evolutek/movement-tracker/V4/Output/movement-tracker V4.1.step

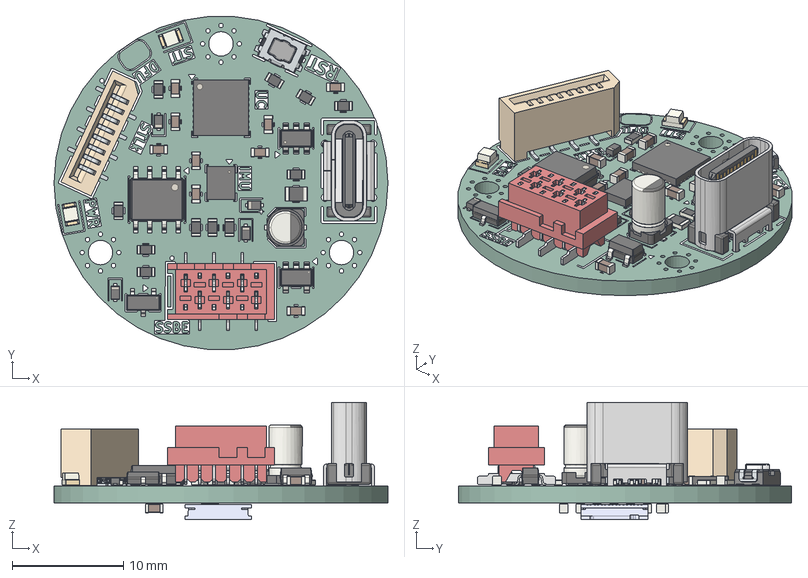
[picture p1: CAD file, 2026-03-30]
V4/Output/movement-tracker V4.1.step
30.0 x 29.9 x 10.5 mm
R_0603_1608Metric x 11
SOT-23
SOT-23-5
D_SOD-523 x 4
QFN-32-1EP_5x5mm_P0.5mm_EP3.45x3.45mm
Frame
Cover
Terminal
Button
SOT-23-6
C_0603_1608Metric x 17
LGA-14_3x2.5mm_P0.5mm_LayoutBorder3x4y
LED_0805_2012Metric x 2
Fuse_0805_2012Metric
CP_Elec_3x5.4
69036728xx76_PIN x 6
SOIC-8_3.9x4.9mm_P1.27mm
6861xx188822_Pin1 x 4
6861xx188822_Pin2 x 4
632722110112_Shielding
632722110112_Housing
632722110112_Shielding_2 x 2
632722110112_Shielding_3 x 2
632722110112_Pin_1 x 4
632722110112_Pin_2 x 16
632722110112_Pin_3 x 4
PAA5160E1-Q-16L-6x6-LGA
movement-tracker_silkscreen x 2
movement-tracker_PCB
