evolutek/movement-tracker/V1/module-optique-grand/Output/module-optique-grand.step

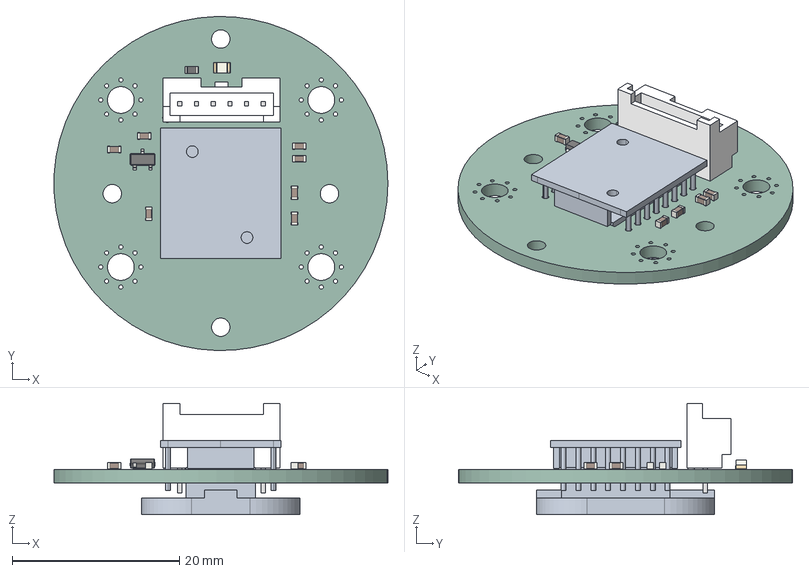
[picture p2: CAD file, 2023-09-23, an earlier design]
V1/module-optique-grand/Output/module-optique-grand.step
40.0 x 40.0 x 13.3 mm
module-optique-grand PCB
