evolutek/movement-tracker/V1/module-optique-mini/Output/module-optique.step

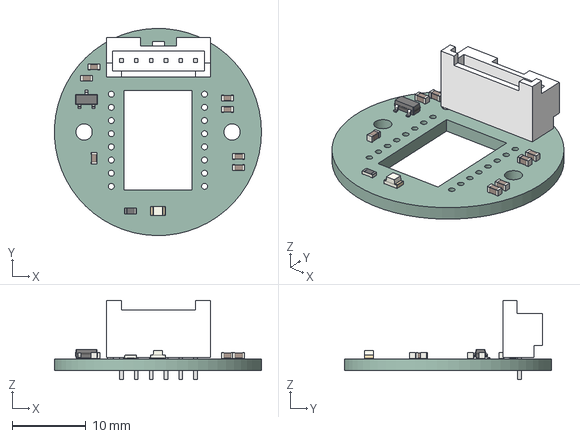
[picture p3: CAD file, 2023-09-23, an earlier design]
V1/module-optique-mini/Output/module-optique.step
28.0 x 28.0 x 10.7 mm
module-optique PCB
