evolutek/movement-tracker/V4/Output/movement-tracker.pdf

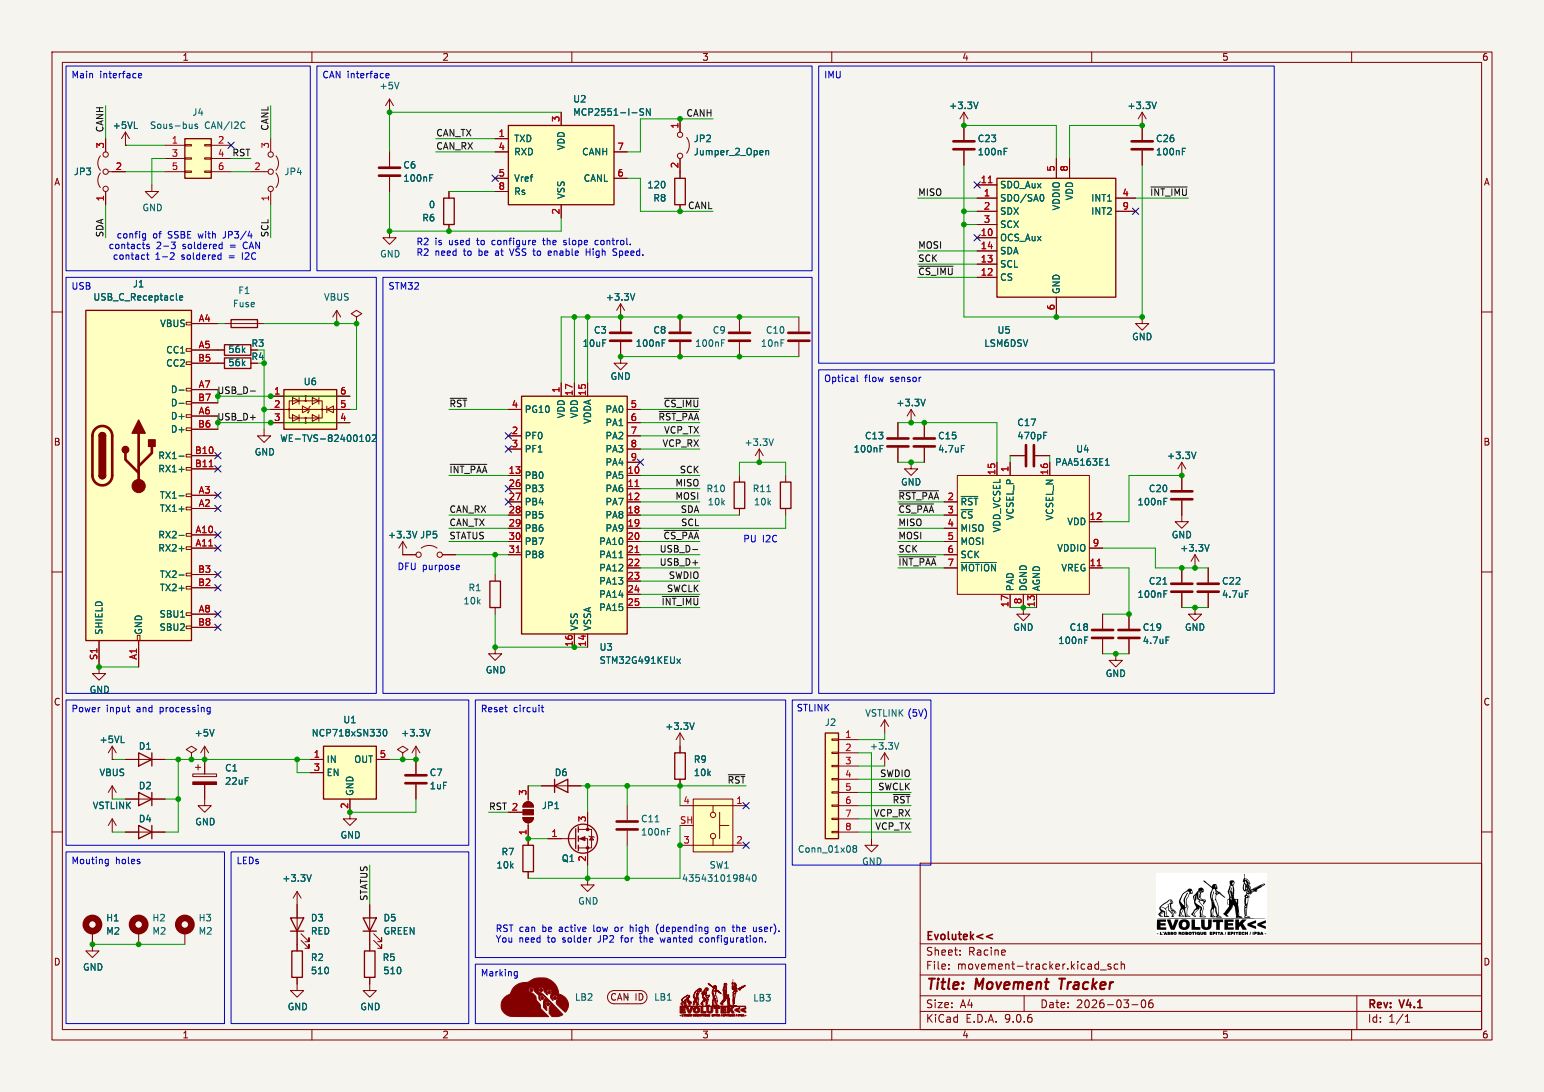
[picture p4: page 1]

Main interface USB Mouting holes

~{CS_IMU} MOSI MISO SDA CANH

4 U6 WE-TVS-82400102 GND GND

1 VDD 17 VSS 16 VDDA 15 VSSA 14 PA0 5 PA1 6 PA2 7 PA3 8 PA4 9 PA5 10 PA6 11 PA7 12 PA8 18 PA9 19 PA10 20 PA11 21 PA12 22 PA13 23 PA14 24 PA15 25 U3STM32G491KEUx R6

config of SSBE with JP3/4

1 VDD 17 VSS 16 VDDA 15 VSSA 14 PA0 5 PA1 6 PA2 7 PA3 8 PA4 9 PA5 10 PA6 11 PA7 12 PA8 18 PA9 19 PA10 20 PA11 21 PA12 22 PA13 23 PA14 24 PA15 25 +3.3V C13

~{CS_PAA} USB_D- SCL SDA MOSI VCP_RX STATUS

8 AGND 13 VCSEL_N 16 VDD 12 VDDIO 9 VREG 11 U4 PAA5163E1 +3.3V

8 AGND 13 VCSEL_N 16 VDD 12 VDDIO 9 VREG 11 +3.3V

LEDs Power input and processing

Id: 1/1 Title: Movement Tracker File: movement-tracker.kicad_sch Sheet: Racine Evolutek<<
