evolutek/movement-tracker/V3/Output/Schematics.pdf

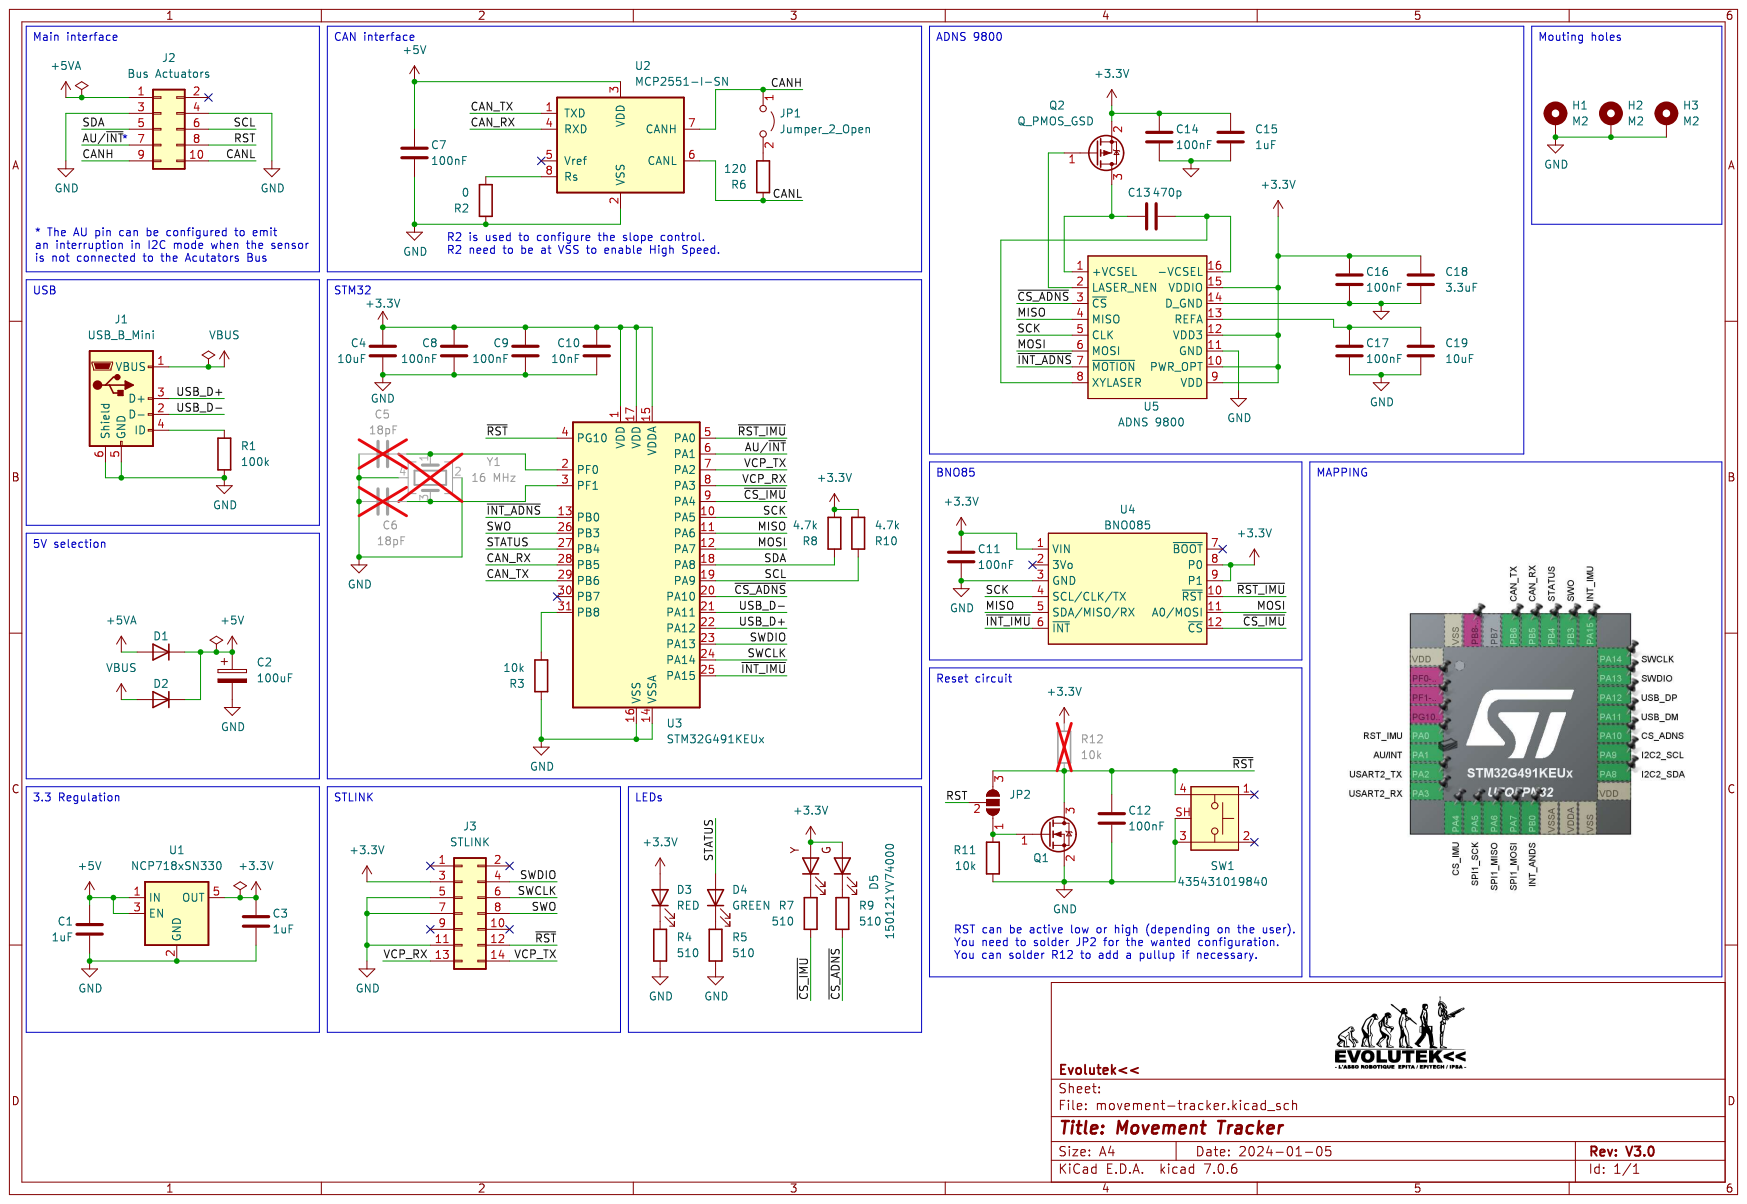
[picture p5: page 1]
