evolutek/movement-tracker/V2/Output/Schematics.pdf

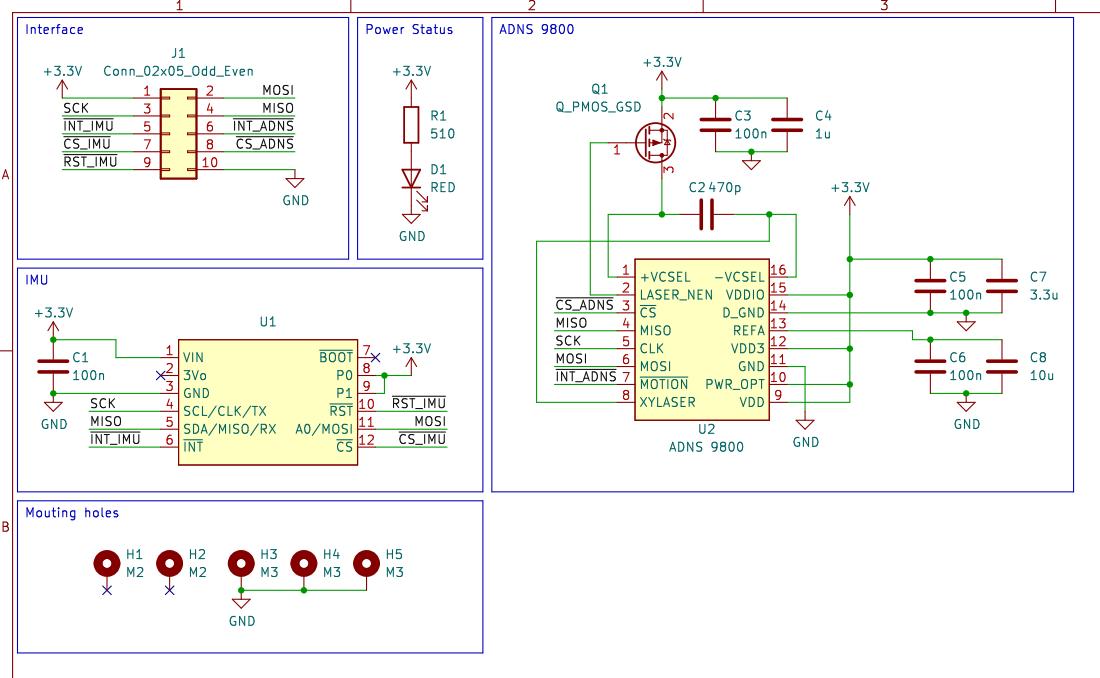
[picture p6: page 1]
