evolutek/movement-tracker/V1/module-optique-grand/Output/Schematics.pdf

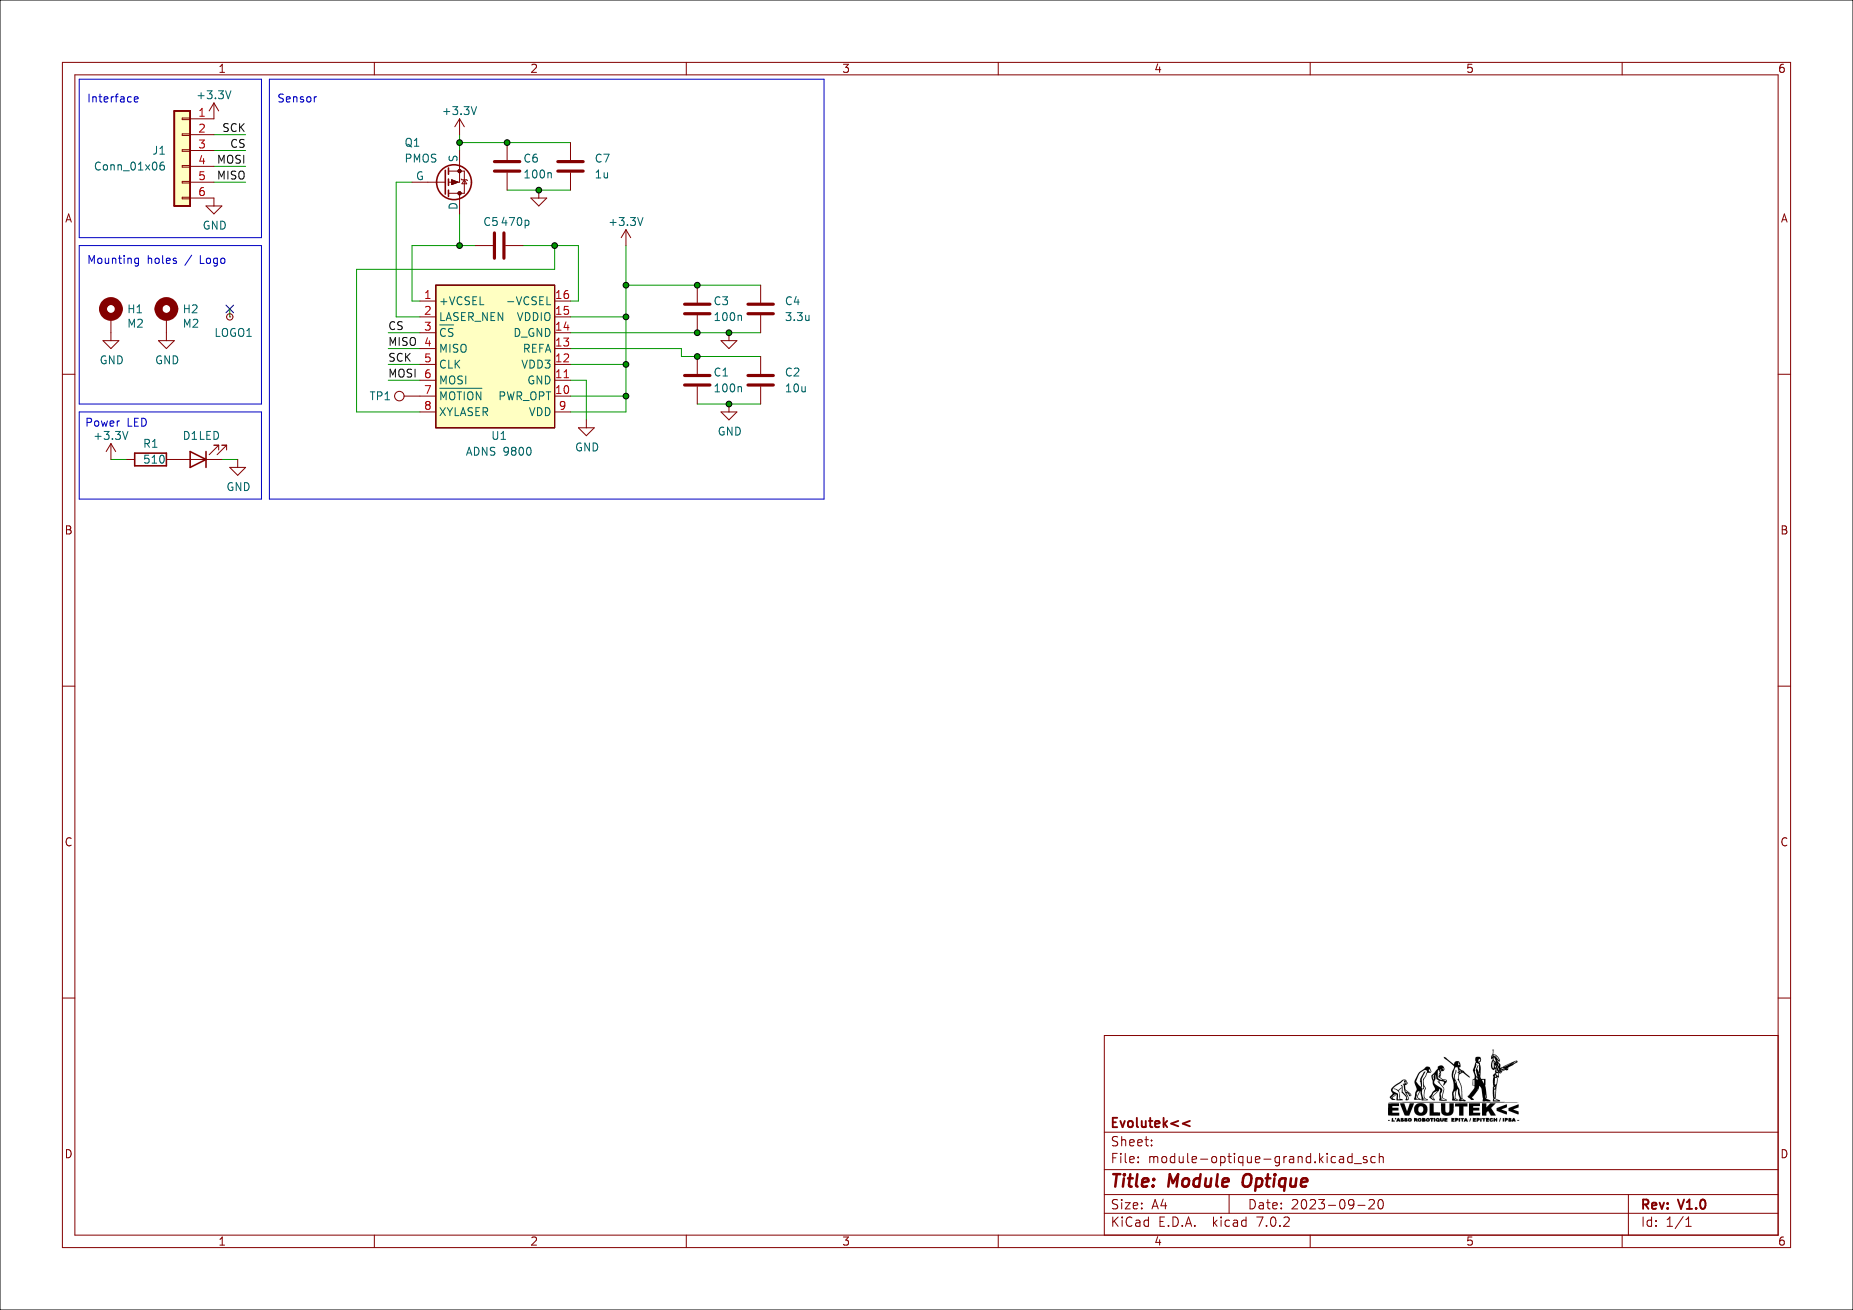
[picture p7: page 1]
