evolutek/movement-tracker/V1/module-optique-mini/Output/Schematics.pdf

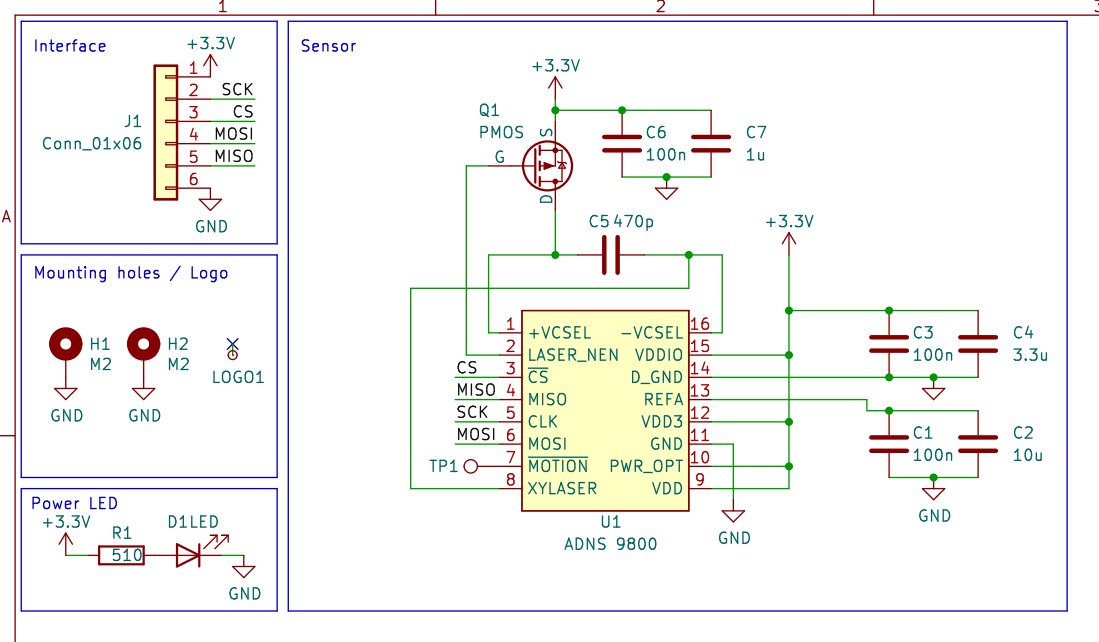
[picture p8: page 1]
