evolutek/movement-tracker/V3/Output/Board-Back.pdf

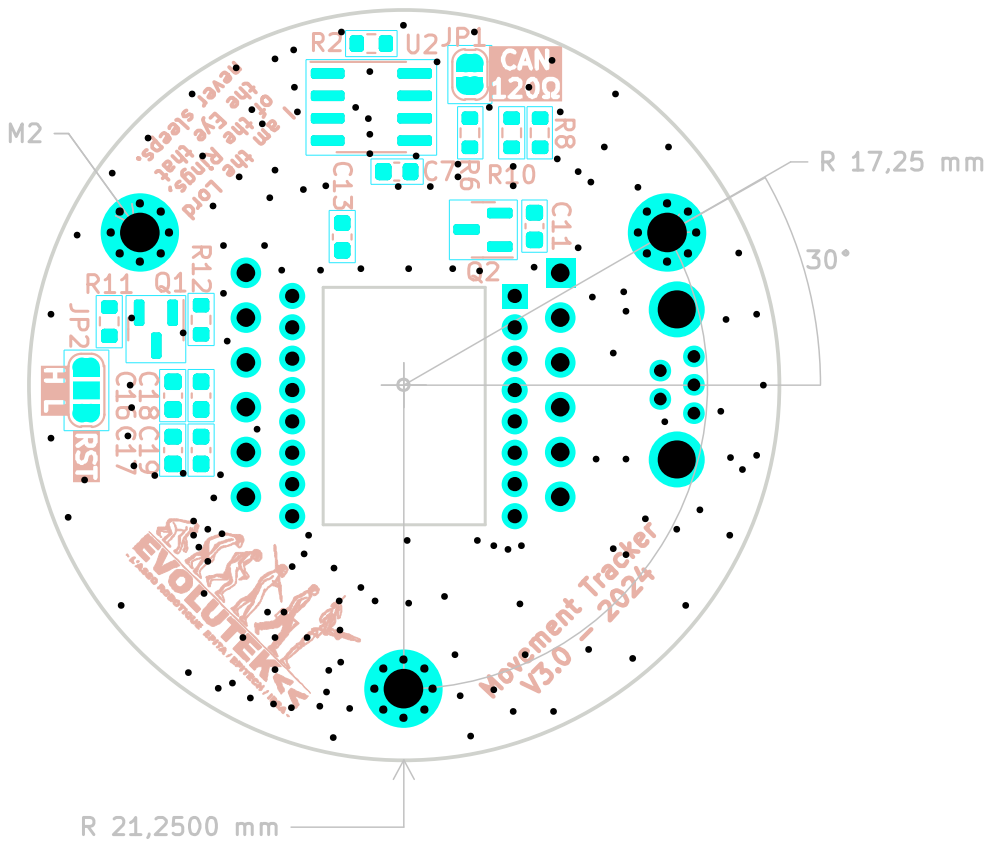
[picture p9: page 1]
