evolutek/movement-tracker/V3/Output/Board-Front.pdf

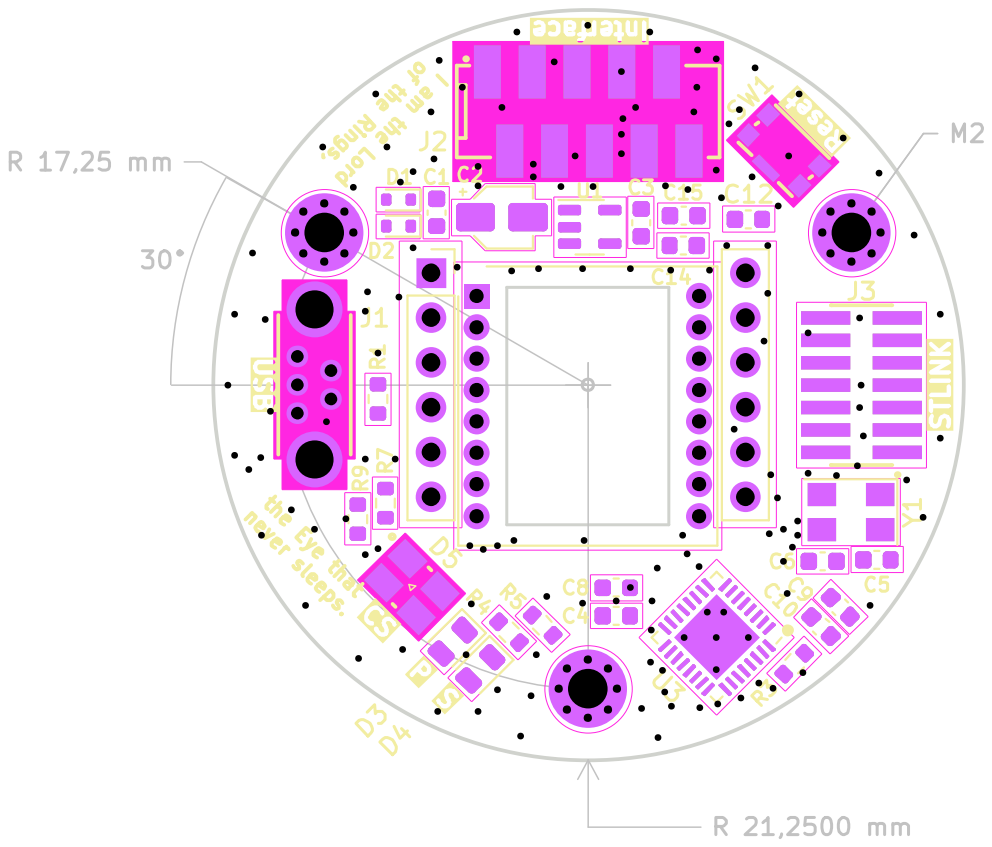
[picture p10: page 1]
