evolutek/movement-tracker/V2/Output/Board-Back.pdf

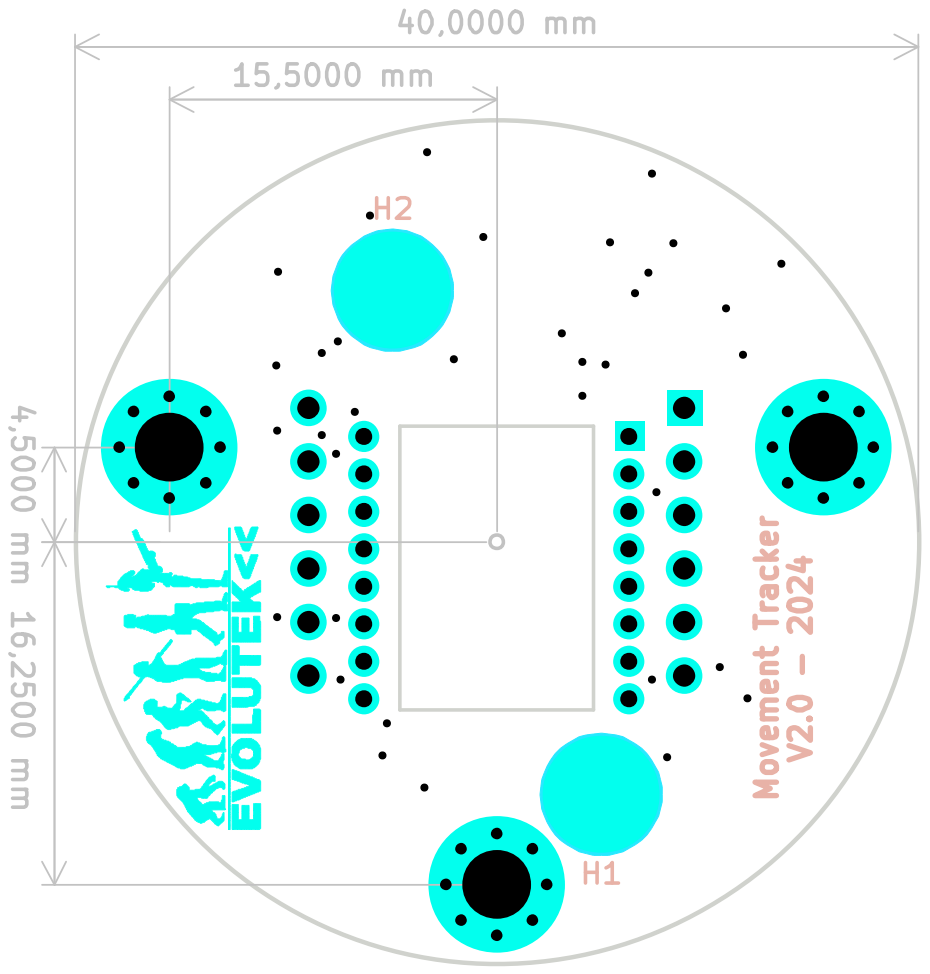
[picture p11: page 1]
