evolutek/movement-tracker/V2/Output/Board-Front.pdf

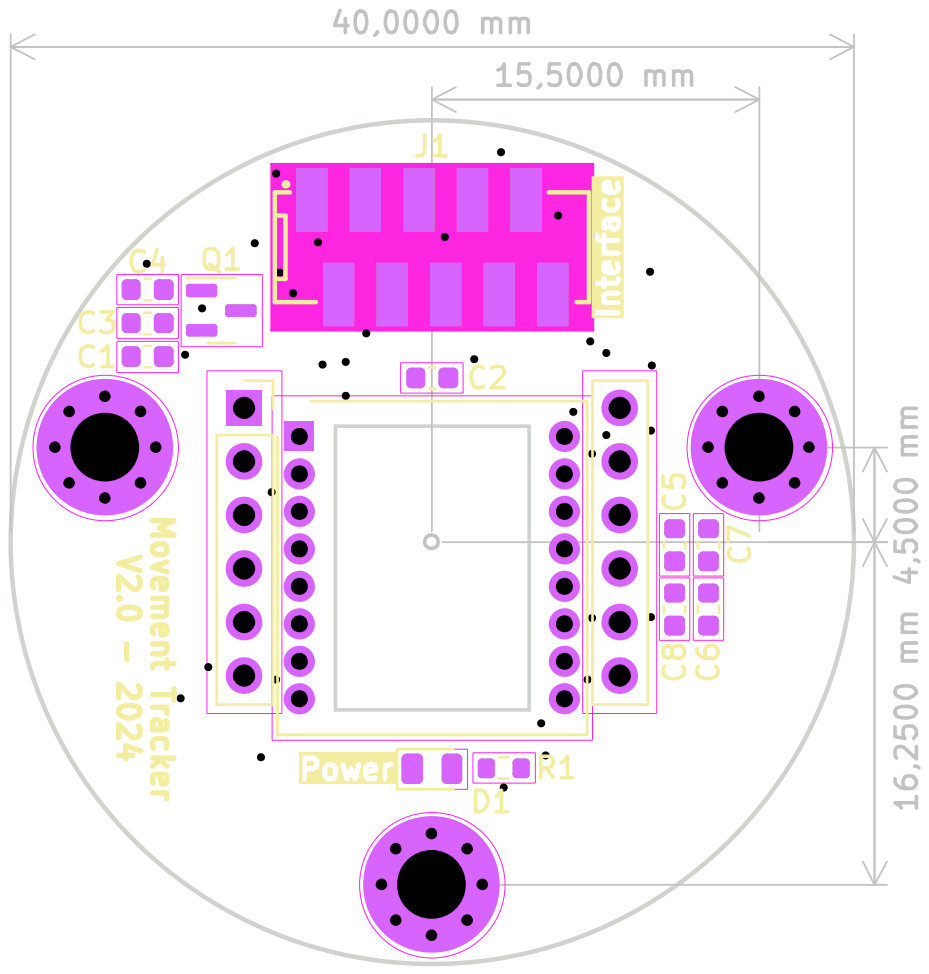
[picture p12: page 1]
