evolutek/movement-tracker/V1/module-optique-grand/Output/Board-Front.pdf

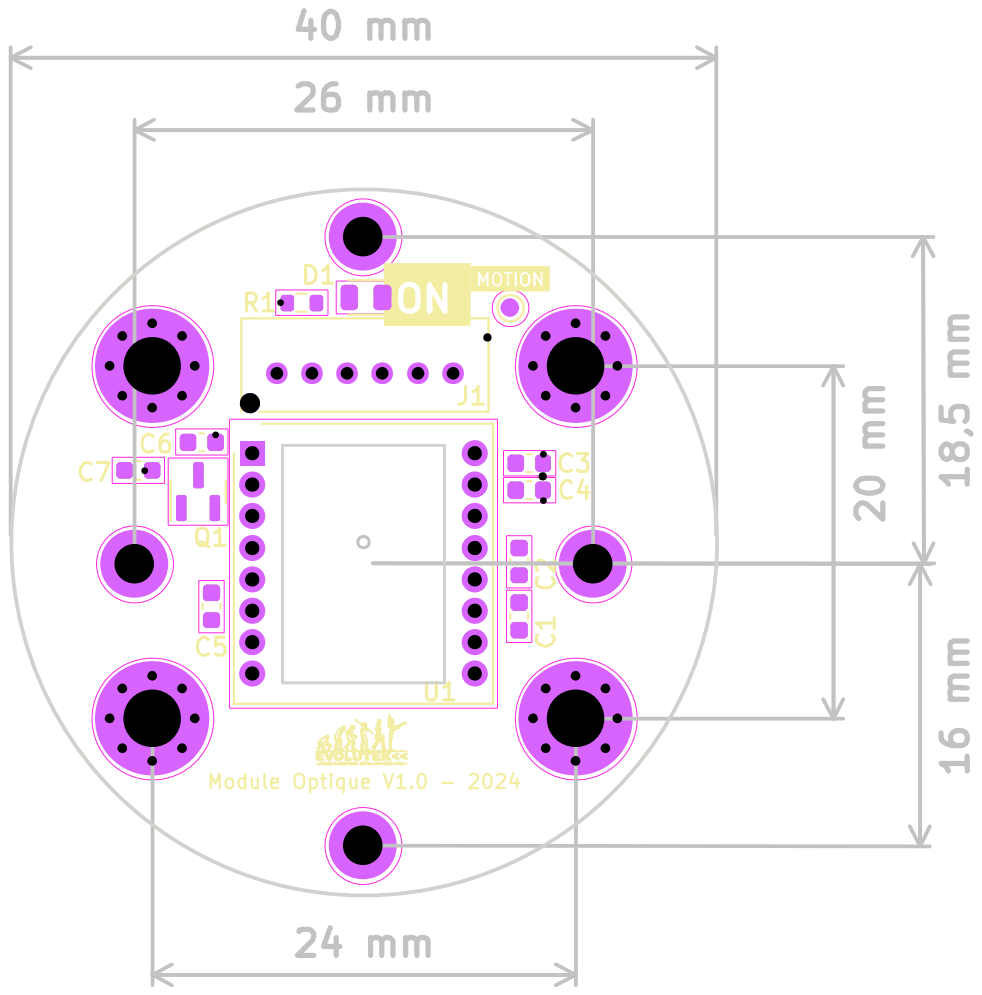
[picture p13: page 1]
