evolutek/movement-tracker/V1/module-optique-mini/Output/Board-Back.pdf

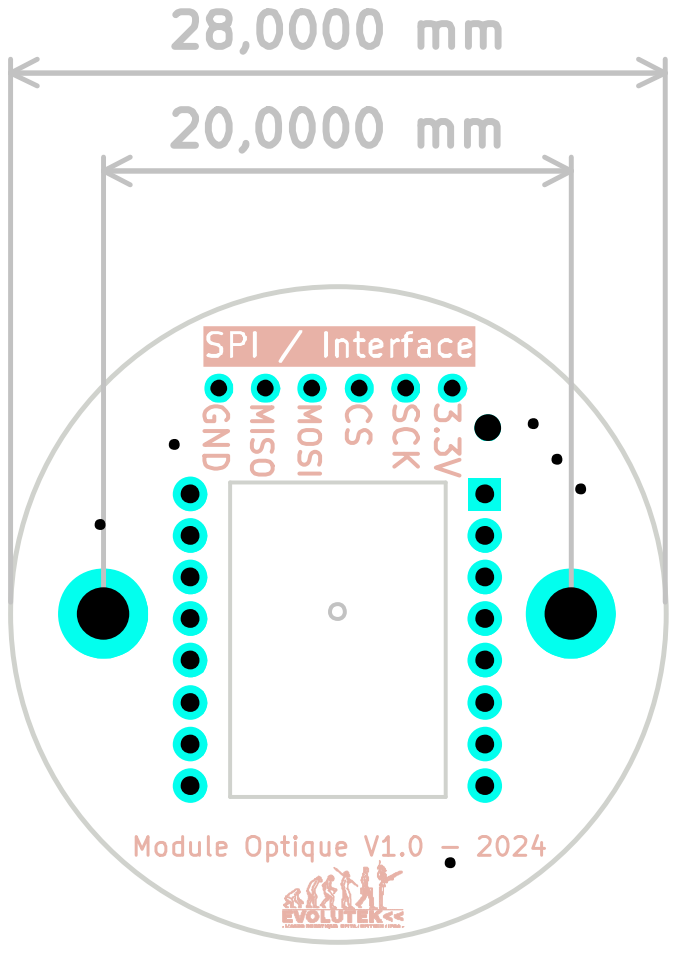
[picture p14: page 1]
