evolutek/movement-tracker/V1/module-optique-mini/Output/Board-Front.pdf

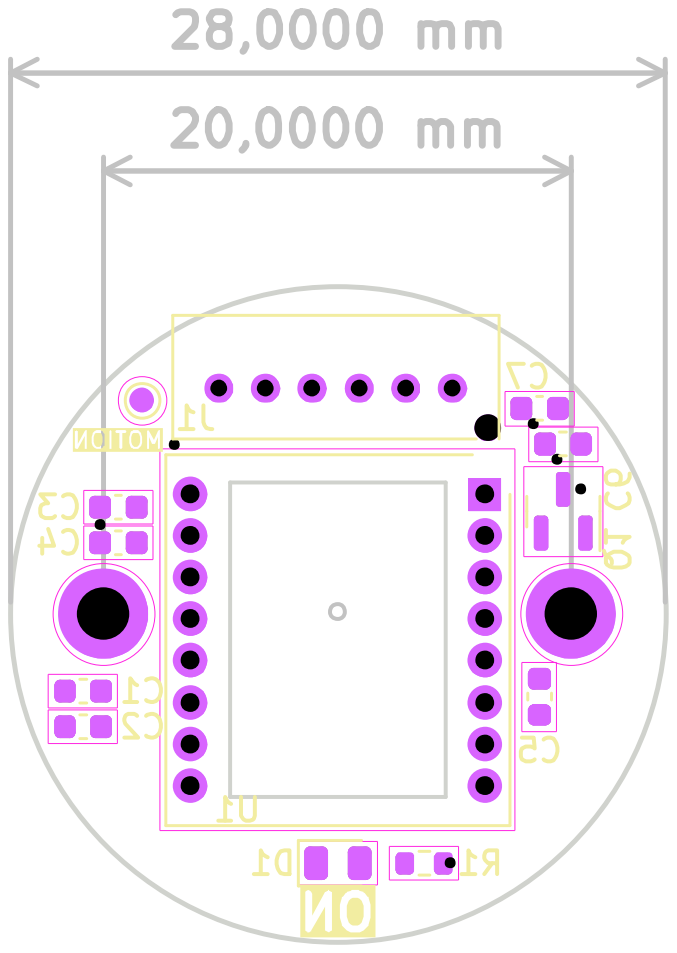
[picture p15: page 1]
