evolutek/movement-tracker/V4/movement-tracker.kicad_pcb

## KiCad design V4/movement-tracker.kicad_pcb (2026-02-24)

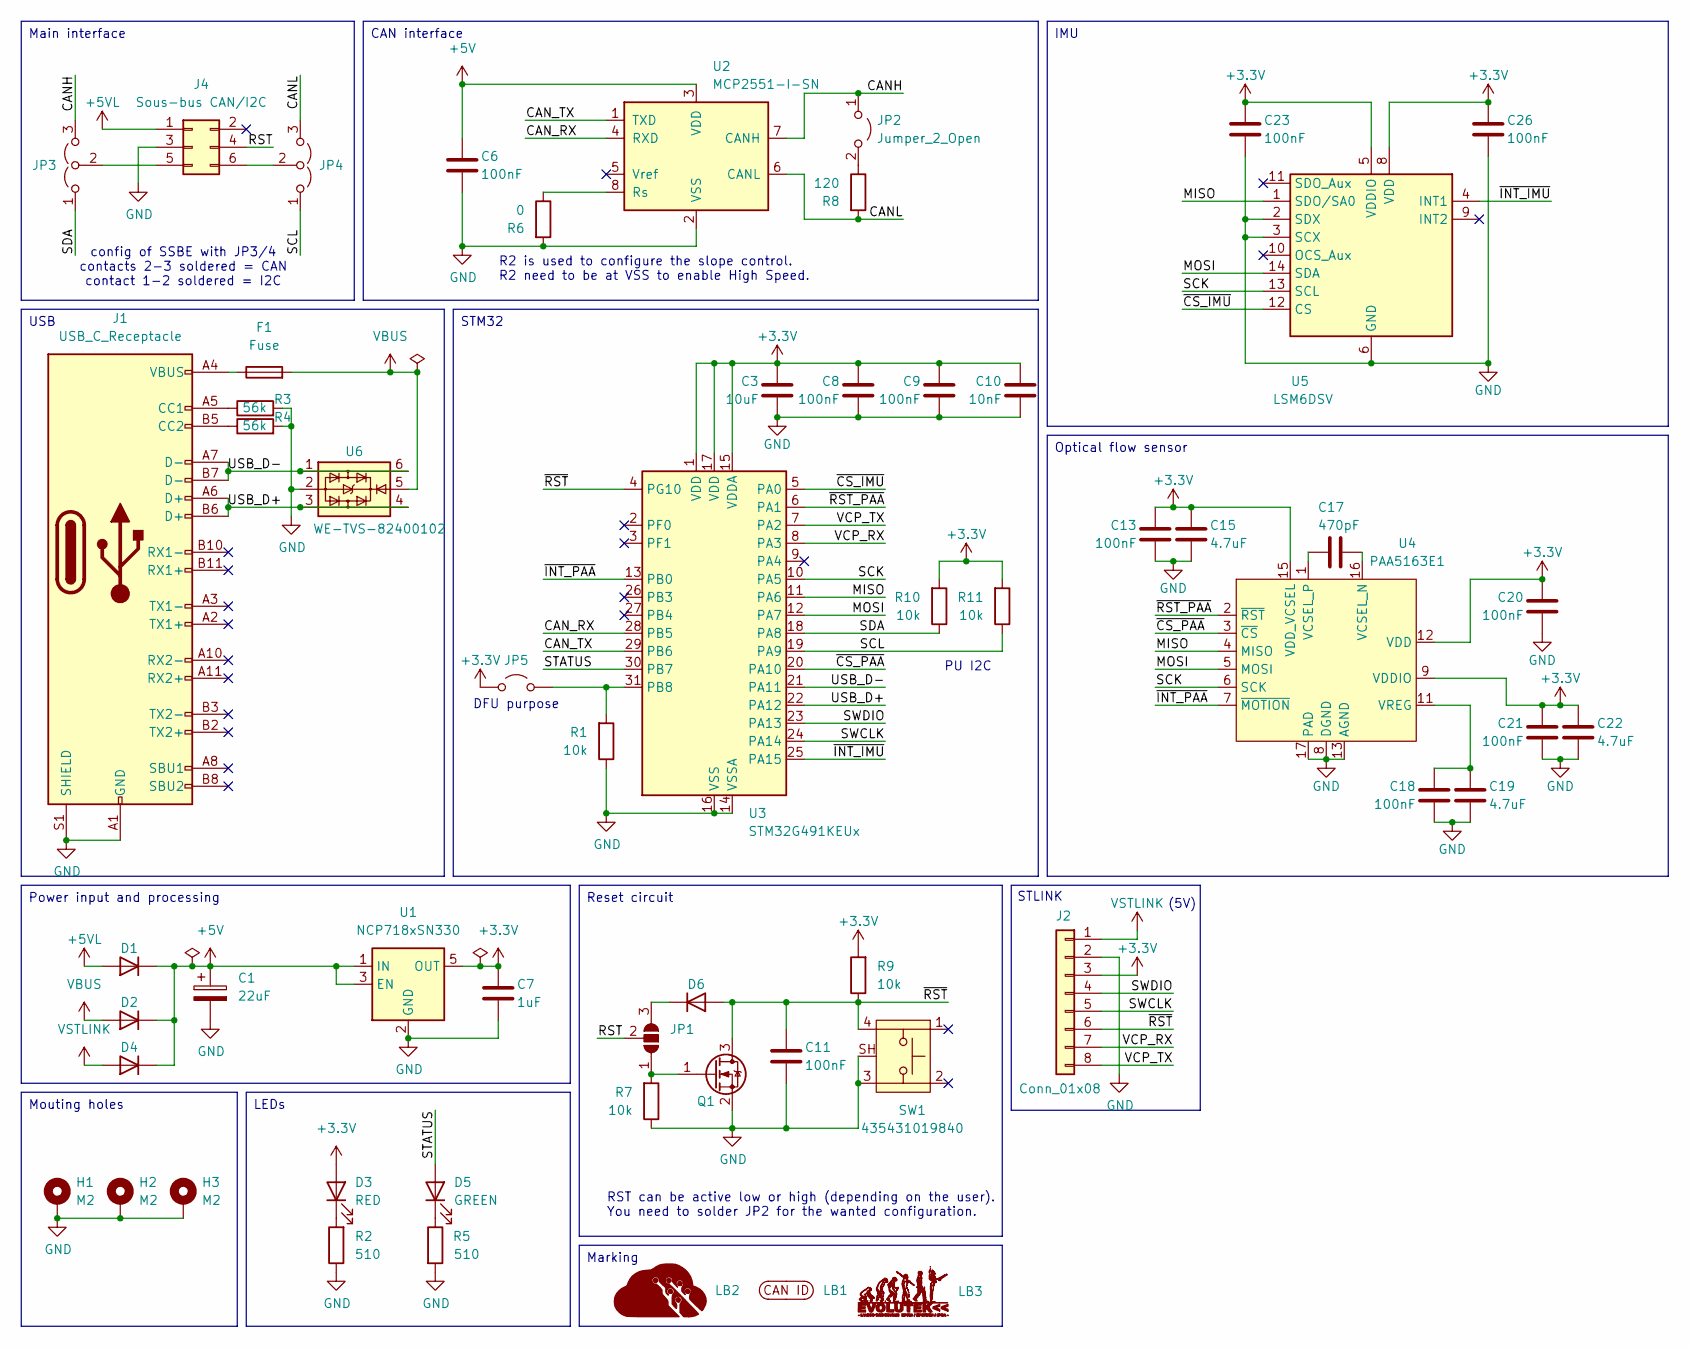
[picture p16: schematic movement-tracker.kicad_sch, Movement Tracker]

Parts:
C1: 22uF; CP_Elec_3x5.4
C3: 10uF; C_0603_1608Metric
C6, C8, C9, C11, C13, C18, C20, C21, C23, C26: 100nF; C_0603_1608Metric
C7: 1uF; C_0603_1608Metric
C10: 10nF; C_0603_1608Metric
C15, C19, C22: 4.7uF; C_0603_1608Metric
C17: 470pF; C_0603_1608Metric
D1, D2, D4, D6: D; D_SOD-523
D3: RED; LED_0805_2012Metric
D5: GREEN; LED_0805_2012Metric
F1: Fuse; Fuse_0805_2012Metric
H1, H2, H3: M2; MountingHole_2.2mm_M2_Pad_Via
J1: USB_C_Receptacle; 632722110112
J2: Conn_01x08; 686108188822
J4: Sous-bus CAN/I2C; 690367280676
JP1: SolderJumper_3_Bridged12; SolderJumper-3_P1.3mm_Open_RoundedPad1.0x1.5mm_NumberLabels
JP2, JP5: Jumper_2_Open; SolderJumper-2_P1.3mm_Open_RoundedPad1.0x1.5mm
JP3, JP4: Jumper_3_Open; SolderJumper-3_P1.3mm_Open_RoundedPad1.0x1.5mm_NumberLabels
LB1: CAN ID Label
LB2: LOGO; Logo Aisler Min
LB3: LOGO; logo-evo-min
Q1: Q_NMOS_GSD; SOT-23
R1, R7, R9, R10, R11: 10k; R_0603_1608Metric
R2, R5: 510; R_0603_1608Metric
R3, R4: 56k; R_0603_1608Metric
R6: 0; R_0603_1608Metric
R8: 120; R_0603_1608Metric
SW1: 435431019840
U1: NCP718xSN330; SOT-23-5
U2: MCP2551-I-SN; SOIC-8_3.9x4.9mm_P1.27mm
U3: STM32G491KEUx; QFN-32-1EP_5x5mm_P0.5mm_EP3.45x3.45mm-Without thermal pad
U4: PAA5163E1
U5: LSM6DSV; LGA-14_3x2.5mm_P0.5mm_LayoutBorder3x4y
U6: WE-TVS-82400102; SOT-23-6

Connections:
+3.3V: C3.1, C7.1, C8.1, C9.1, C10.1, C13.2, C15.2, C20.2, C21.2, C22.2, C23.1, C26.1, D3.2 (A), J2.3, JP5.1 (A), R9.2, R10.2, R11.2, U1.5 (OUT), U3.1 (VDD), U3.15 (VDDA), U3.17 (VDD), U4.9 (VDDIO), U4.12 (VDD), U4.15 (VDD_VCSEL), U5.5 (VDDIO), U5.8 (VDD)
+5V: C1.1, C6.1, D1.1 (K), D2.1 (K), D4.1 (K), U1.1 (IN), U1.3 (EN), U2.3 (VDD)
+5VL: D1.2 (A), J4.1
/CANH: JP2.1 (A), JP3.3 (B), U2.7 (CANH)
/CANL: JP4.3 (B), R8.2, U2.6 (CANL)
/CAN_RX: U2.4 (RXD), U3.28 (PB5)
/CAN_TX: U2.1 (TXD), U3.29 (PB6)
/MISO: U3.11 (PA6), U4.4 (MISO), U5.1 (SDO/SA0)
/MOSI: U3.12 (PA7), U4.5 (MOSI), U5.14 (SDA)
/RST: J4.4, JP1.2 (C)
/SCK: U3.10 (PA5), U4.6 (SCK), U5.13 (SCL)
/SCL: JP4.1 (A), R11.1, U3.19 (PA9)
/SDA: JP3.1 (A), R10.1, U3.18 (PA8)
/STATUS: D5.2 (A), U3.30 (PB7)
/SWCLK: J2.5, U3.24 (PA14)
/SWDIO: J2.4, U3.23 (PA13)
/USB_D+: J1.A6 (D+), J1.B6 (D+), U3.22 (PA12), U6.3, U6.4
/USB_D-: J1.A7 (D-), J1.B7 (D-), U3.21 (PA11), U6.1, U6.6
/VCP_RX: J2.7, U3.8 (PA3)
/VCP_TX: J2.8, U3.7 (PA2)
/~CS_IMU: U3.5 (PA0), U5.12 (CS)
/~CS_PAA: U3.20 (PA10), U4.3 (~CS)
/~INT_IMU: U3.25 (PA15), U5.4 (INT1)
/~INT_PAA: U3.13 (PB0), U4.7 (~MOTION)
/~RST_PAA: U3.6 (PA1), U4.2 (~RST)
/~RST: C11.1, D6.2 (A), J2.6, Q1.3 (D), R9.1, SW1.4, U3.4 (PG10)
GND: C1.2, C3.2, C6.2, C7.2, C8.2, C9.2, C10.2, C11.2, C13.1, C15.1, C18.1, C19.1, C20.1, C21.1, C22.1, C23.2, C26.2, H1.1, H2.1, H3.1, J1.A1 (GND), J1.A12 (GND), J1.B1 (GND), J1.B12 (GND), J1.S1 (SHIELD), J2.2, J4.3, Q1.2 (S), R1.1, R2.1, R3.2, R4.2, R5.2, R6.2, R7.1, SW1.3, SW1.SH, U1.2 (GND), U2.2 (VSS), U3.14 (VSSA), U3.16 (VSS), U3.32 (VSS), U4.8 (DGND), U4.13 (AGND), U4.17 (PAD), U5.2 (SDX), U5.3 (SCX), U5.6 (GND), U5.7 (GND), U6.2
unnamed: D3.1 (K), R2.2
unnamed: D5.1 (K), R5.1
unnamed: D6.1 (K), JP1.3 (B)
unnamed: F1.1, J1.A4 (VBUS), J1.A9 (VBUS), J1.B4 (VBUS), J1.B9 (VBUS)
unnamed: J1.A5 (CC1), R3.1
unnamed: J1.B5 (CC2), R4.1
unnamed: J4.5, JP3.2 (C)
unnamed: J4.6, JP4.2 (C)
unnamed: JP1.1 (A), Q1.1 (G), R7.2
unnamed: JP2.2 (B), R8.1
unnamed: JP5.2 (B), R1.2, U3.31 (PB8)
unnamed: R6.1, U2.8 (Rs)
unnamed: C17.1, U4.16 (VCSEL_N)
unnamed: C17.2, U4.1 (VCSEL_P)
unnamed: C18.2, C19.2, U4.11 (VREG)
VBUS: D2.2 (A), F1.2, U6.5
VSTLINK: D4.2 (A), J2.1

Notes on the sheet:
(5V)
PU I2C
DFU purpose
config of SSBE with JP3/4 contacts 2-3 soldered = CAN contact 1-2 soldered = I2C
STLINK
RST can be active low or high (depending on the user). You need to solder JP2 for the wanted configuration.
R2 is used to configure the slope control. R2 need to be at VSS to enable High Speed.
Optical flow sensor
Power input and processing
Reset circuit
IMU
CAN interface
Mouting holes
USB
Marking
STM32
LEDs
Main interface

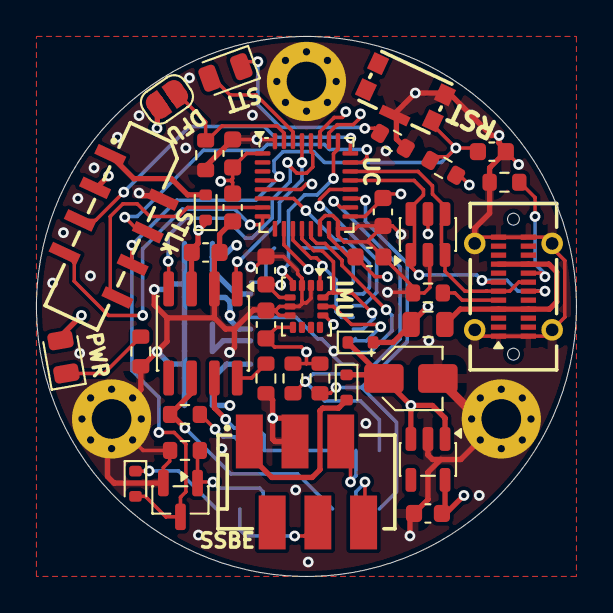
[picture p17: board V4/movement-tracker.kicad_pcb from above]

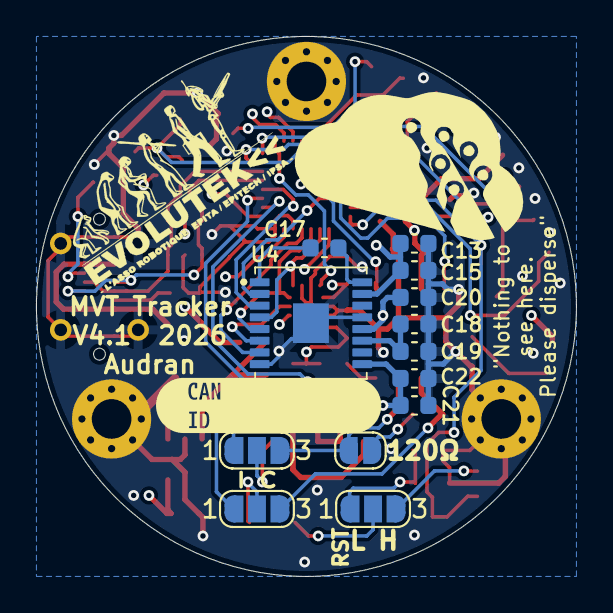
[picture p18: board V4/movement-tracker.kicad_pcb from below]

Board: 4 copper layers, 30.0 x 30.0 mm, 58 parts (16 on the bottom side), 44 nets.
