evolutek/movement-tracker/V3/movement-tracker.kicad_pcb

## KiCad design V3/movement-tracker.kicad_pcb (2024-02-21, an earlier design)

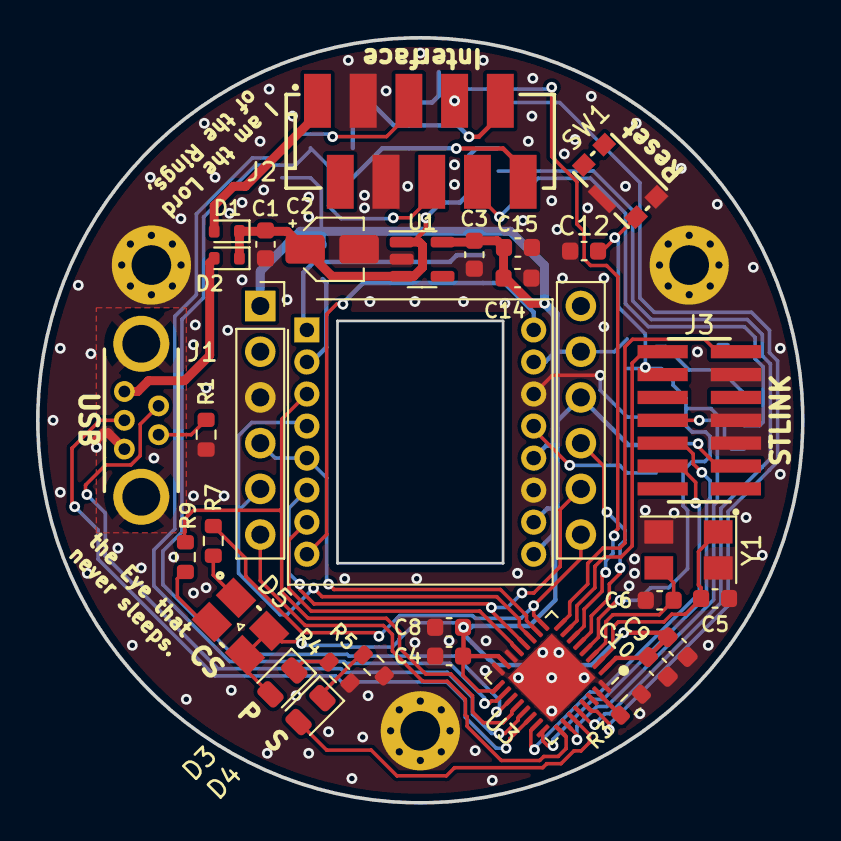
[picture p19: board V3/movement-tracker.kicad_pcb from above]

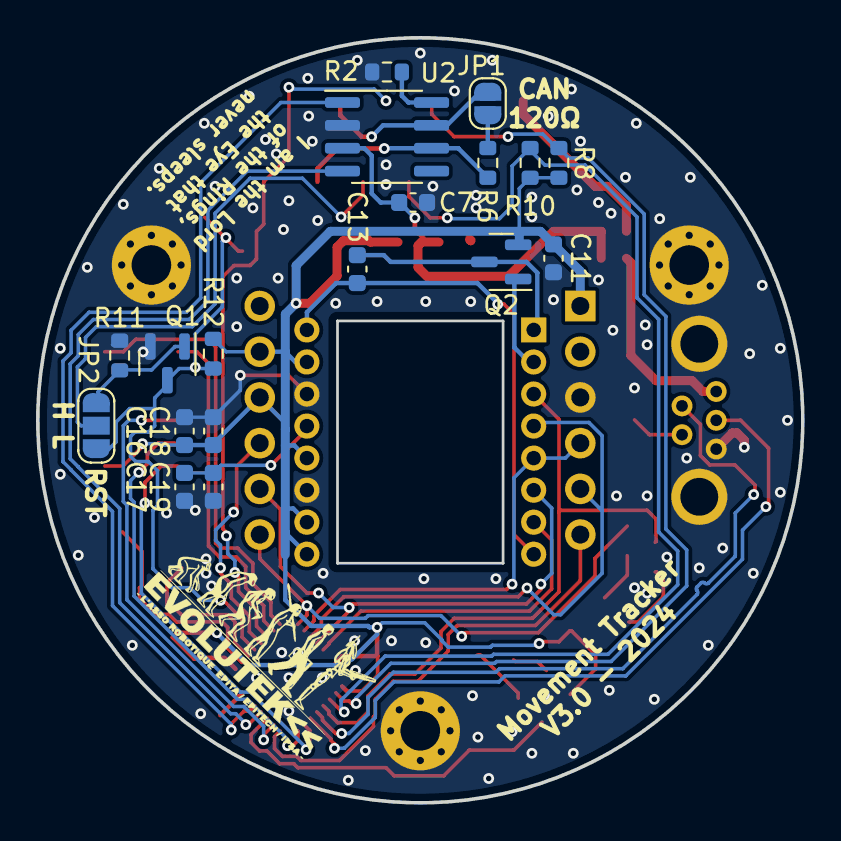
[picture p20: board V3/movement-tracker.kicad_pcb from below]

Board: 2 copper layers, 42.5 x 42.5 mm, 53 parts (18 on the bottom side), 45 nets.

Parts:
C1, C3, C15: 1uF; C_0603_1608Metric
C2: 100uF; CP_Elec_3x5.4
C4, C19: 10uF; C_0603_1608Metric
C5, C6: 18pF; C_0603_1608Metric
C7, C8, C9, C11, C12, C14, C16, C17: 100nF; C_0603_1608Metric
C10: 10nF; C_0603_1608Metric
C13: 470p; C_0603_1608Metric
C18: 3.3uF; C_0603_1608Metric
D1, D2: D; D_SOD-523
D3: RED; LED_0805_2012Metric
D4: GREEN; LED_0805_2012Metric
D5: 150121YV74000; WL-SBCW_1210
H1, H2, H3: M2; MountingHole_2.2mm_M2_Pad_Via
J1: USB_B_Mini; 651005136421
J2: Bus Actuators; 690367281076
J3: STLINK; SAMTEC_FTSH-107-01-L-DV-K
JP1: Jumper_2_Open; SolderJumper-2_P1.3mm_Open_RoundedPad1.0x1.5mm
JP2: SolderJumper_3_Bridged12; SolderJumper-3_P1.3mm_Open_RoundedPad1.0x1.5mm_NumberLabels
Q1: Q_NMOS_GSD; SOT-23
Q2: Q_PMOS_GSD; SOT-23
R1: 100k; R_0603_1608Metric
R2: 0; R_0603_1608Metric
R3, R11, R12: 10k; R_0603_1608Metric
R4, R5, R7, R9: 510; R_0603_1608Metric
R6: 120; R_0603_1608Metric
R8, R10: 4.7k; R_0603_1608Metric
SW1: 435431019840
U1: NCP718xSN330; SOT-23-5
U2: MCP2551-I-SN; SOIC-8_3.9x4.9mm_P1.27mm
U3: STM32G491KEUx; QFN-32-1EP_5x5mm_P0.5mm_EP3.45x3.45mm
U4: BNO085; Adafruit BNO085
U5: ADNS 9800
Y1: 16 MHz; Crystal_SMD_5032-4Pin_5.0x3.2mm

Connections:
+3.3V: C3.1, C4.1, C8.1, C9.1, C10.1, C11.1, C14.1, C15.1, C16.1, C18.1, D3.2 (A), D5.3 (AG), D5.4 (AY), J3.3, Q2.2 (S), R8.1, R10.1, R12.2, U1.5 (OUT), U3.1 (VDD), U3.15 (VDDA), U3.17 (VDD), U4.1 (VIN), U4.8 (P0), U4.9 (P1), U5.9 (VDD), U5.10 (PWR_OPT), U5.12 (VDD3), U5.15 (VDDIO)
+5V: C1.1, C2.1, C7.1, D1.1 (K), D2.1 (K), U1.1 (IN), U1.3 (EN), U2.3 (VDD)
+5VA: D1.2 (A), J2.1
/AU/~INT: J2.7, U3.6 (PA1)
/CANH: J2.9, JP1.1 (A), U2.7 (CANH)
/CANL: J2.10, R6.2, U2.6 (CANL)
/CAN_RX: U2.4 (RXD), U3.28 (PB5)
/CAN_TX: U2.1 (TXD), U3.29 (PB6)
/MISO: U3.11 (PA6), U4.5 (SDA/MISO/RX), U5.4 (MISO)
/MOSI: U3.12 (PA7), U4.11 (A0/MOSI), U5.6 (MOSI)
/RST: J2.8, JP2.2 (C)
/SCK: U3.10 (PA5), U4.4 (SCL/CLK/TX), U5.5 (CLK)
/SCL: J2.6, R10.2, U3.19 (PA9)
/SDA: J2.5, R8.2, U3.18 (PA8)
/STATUS: D4.2 (A), U3.27 (PB4)
/SWCLK: J3.6, U3.24 (PA14)
/SWDIO: J3.4, U3.23 (PA13)
/SWO: J3.8, U3.26 (PB3)
/USB_D+: J1.3 (D+), U3.22 (PA12)
/USB_D-: J1.2 (D-), U3.21 (PA11)
/VCP_RX: J3.13, U3.8 (PA3)
/VCP_TX: J3.14, U3.7 (PA2)
/~CS_ADNS: R9.1, U3.20 (PA10), U5.3 (~CS)
/~CS_IMU: R7.1, U3.9 (PA4), U4.12 (~CS)
/~INT_ADNS: U3.13 (PB0), U5.7 (~MOTION)
/~INT_IMU: U3.25 (PA15), U4.6 (~INT)
/~RST_IMU: U3.5 (PA0), U4.10 (~RST)
/~RST: C12.1, J3.12, JP2.3 (B), Q1.3 (D), R12.1, SW1.4, U3.4 (PG10)
GND: C1.2, C2.2, C3.2, C4.2, C5.1, C6.1, C7.2, C8.2, C9.2, C10.2, C11.2, C12.2, C14.2, C15.2, C16.2, C17.2, C18.2, C19.2, H1.1, H2.1, H3.1, J1.5 (GND), J1.6 (Shield), J2.3, J2.4, J3.5, J3.7, J3.11, Q1.2 (S), R1.1, R2.2, R3.2, R4.1, R5.1, R11.1, SW1.3, SW1.SH, U1.2 (GND), U2.2 (VSS), U3.14 (VSSA), U3.16 (VSS), U3.32 (VSS), U3.33 (VSS), U4.3 (GND), U5.11 (GND), U5.14 (D_GND), Y1.2, Y1.4
unnamed: D3.1 (K), R4.2
unnamed: D4.1 (K), R5.2
unnamed: D5.2 (KG), R9.2
unnamed: D5.1 (KY), R7.2
unnamed: J1.4 (ID), R1.2
unnamed: JP1.2 (B), R6.1
unnamed: JP2.1 (A), Q1.1 (G), R11.2
unnamed: C13.1, Q2.3 (D), U5.1 (+VCSEL)
unnamed: Q2.1 (G), U5.2 (LASER_NEN)
unnamed: R2.1, U2.8 (Rs)
unnamed: R3.1, U3.31 (PB8)
unnamed: C5.2, U3.2 (PF0), Y1.1
unnamed: C6.2, U3.3 (PF1), Y1.3
unnamed: C13.2, U5.8 (XYLASER), U5.16 (-VCSEL)
unnamed: C17.1, C19.1, U5.13 (REFA)
VBUS: D2.2 (A), J1.1 (VBUS)
