evolutek/movement-tracker/V2/movement-tracker.kicad_pcb

## KiCad design V2/movement-tracker.kicad_pcb (2023-12-18, an earlier design)

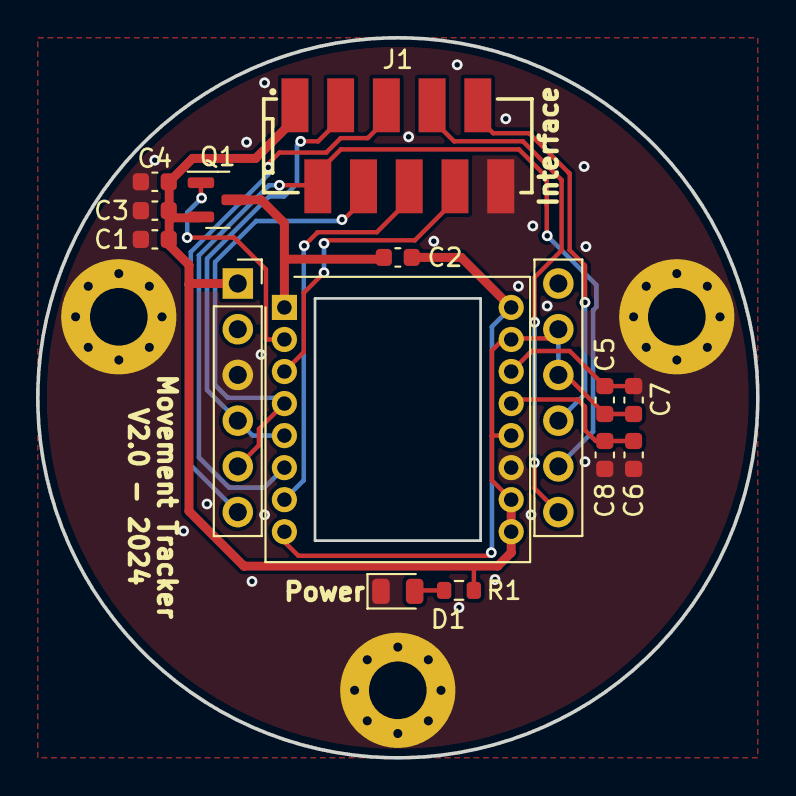
[picture p21: board V2/movement-tracker.kicad_pcb from above]

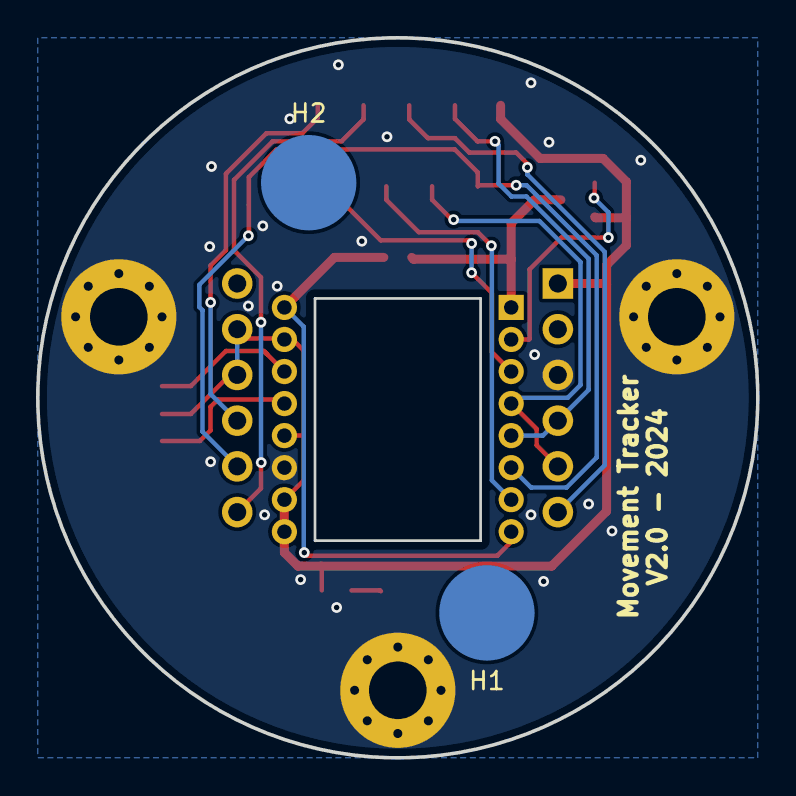
[picture p22: board V2/movement-tracker.kicad_pcb from below]

Board: 2 copper layers, 40.0 x 40.0 mm, 19 parts (2 on the bottom side), 15 nets.

Parts:
C1, C3, C5, C6: 100n; C_0603_1608Metric
C2: 470p; C_0603_1608Metric
C4: 1u; C_0603_1608Metric
C7: 3.3u; C_0603_1608Metric
C8: 10u; C_0603_1608Metric
D1: RED; LED_0805_2012Metric
H1, H2: M2; WA-SMSI_9774015243_Reversed
H3, H4, H5: M3; MountingHole_3.2mm_M3_Pad_Via
J1: Conn_02x05_Odd_Even; 690367281076
Q1: Q_PMOS_GSD; SOT-23
R1: 510; R_0603_1608Metric
U1: Adafruit BNO085
U2: ADNS 9800

Connections:
+3V3: C1.1, C3.1, C4.1, C5.1, C7.1, J1.1, Q1.2 (S), R1.2, U1.1 (VIN), U1.8 (P0), U1.9 (P1), U2.9 (VDD), U2.10 (PWR_OPT), U2.12 (VDD3), U2.15 (VDDIO)
/MISO: J1.4, U1.5 (SDA/MISO/RX), U2.4 (MISO)
/MOSI: J1.2, U1.11 (A0/MOSI), U2.6 (MOSI)
/SCK: J1.3, U1.4 (SCL/CLK/TX), U2.5 (CLK)
/~CS_ADNS: J1.8, U2.3 (~CS)
/~CS_IMU: J1.7, U1.12 (~CS)
/~INT_ADNS: J1.6, U2.7 (~MOTION)
/~INT_IMU: J1.5, U1.6 (~INT)
/~RST_IMU: J1.9, U1.10 (~RST)
GND: C1.2, C3.2, C4.2, C5.2, C6.2, C7.2, C8.2, D1.1 (K), H3.1, H4.1, H5.1, J1.10, U1.3 (GND), U2.11 (GND), U2.14 (D_GND)
unnamed: D1.2 (A), R1.1
unnamed: C2.1, Q1.3 (D), U2.1 (+VCSEL)
unnamed: Q1.1 (G), U2.2 (LASER_NEN)
unnamed: C2.2, U2.8 (XYLASER), U2.16 (-VCSEL)
unnamed: C6.1, C8.1, U2.13 (REFA)
