evolutek/movement-tracker/V1/module-optique-grand/module-optique-grand.kicad_pcb

## KiCad design V1/module-optique-grand/module-optique-grand.kicad_pcb (2023-09-24, an earlier design)

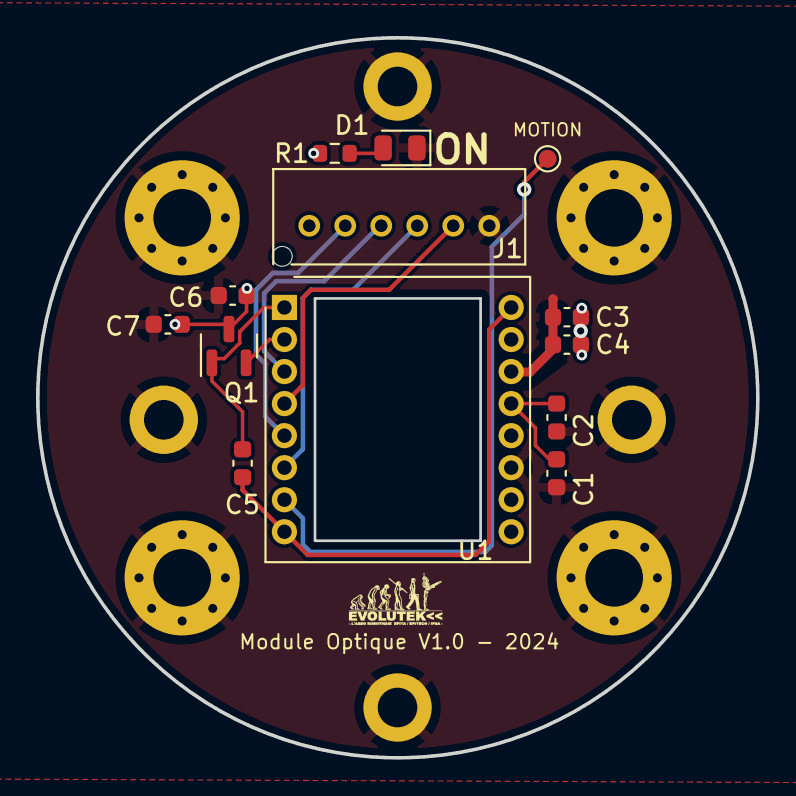
[picture p23: board module-optique-grand.kicad_pcb from above]

Board: 2 copper layers, 40.0 x 40.0 mm, 18 parts (0 on the bottom side), 12 nets.

Parts:
C1, C3, C6: 100n; C_0603_1608Metric
C2: 10u; C_0603_1608Metric
C4: 3.3u; C_0603_1608Metric
C5: 470p; C_0603_1608Metric
C7: 1u; C_0603_1608Metric
D1: LED; LED_0805_2012Metric
H1, H2: M2; MountingHole_2.2mm_M2_DIN965_Pad
Hr: M2; MountingHole_2.2mm_M2_DIN965_Pad
Hr#2: M2; MountingHole_2.2mm_M2_DIN965_Pad
J1: Conn_01x06; B06B-PASK
LOGO1: TestPoint_Small; logo-evo-micro
Q1: PMOS; SOT-23
R1: 510; R_0603_1608Metric
TP1: TestPoint; TestPoint_Pad_D1.0mm
U1: ADNS 9800; ADNS-9800

Connections:
+3V3: C3.1, C4.1, C6.1, C7.1, J1.1, Q1.3 (S), R1.1, U1.9 (VDD), U1.10 (PWR_OPT), U1.12 (VDD3), U1.15 (VDDIO)
/CS: J1.3, U1.3 (~CS)
/MISO: J1.5, U1.4 (MISO)
/MOSI: J1.4, U1.6 (MOSI)
/SCK: J1.2, U1.5 (CLK)
GND: C1.2, C2.2, C3.2, C4.2, C6.2, C7.2, D1.1 (K), H1.1, H2.1, Hr.1, Hr#2.1, J1.6, U1.11 (GND), U1.14 (D_GND)
unnamed: D1.2 (A), R1.2
unnamed: C5.1, Q1.1 (D), U1.1 (+VCSEL)
unnamed: Q1.2 (G), U1.2 (LASER_NEN)
unnamed: C5.2, U1.8 (XYLASER), U1.16 (-VCSEL)
unnamed: C1.1, C2.1, U1.13 (REFA)
unnamed: TP1.1, U1.7 (~MOTION)
