evolutek/movement-tracker/firmware/Core/Src/main.c

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
/* Includes ------------------------------------------------------------------*/
#include "main.h"
#include "usb_device.h"

/* USER CODE BEGIN Includes */
#include "runtime.h"
#include "main.h"
#include "usb_device.h"

#include "BNO085.h"
#include "ADNS9800.h"

#include "movement_tracker.h"

#include "micros.h"
#include <stdio.h>
/* USER CODE END Includes */

FDCAN_HandleTypeDef hfdcan2;

I2C_HandleTypeDef hi2c2;

SPI_HandleTypeDef hspi1;

UART_HandleTypeDef huart2;

void SystemClock_Config(void);
static void MX_GPIO_Init(void);
static void MX_FDCAN2_Init(void);
static void MX_I2C2_Init(void);
static void MX_SPI1_Init(void);
static void MX_USART2_UART_Init(void);
/* USER CODE BEGIN 0 */
int __io_putchar(char ch)
{
	HAL_UART_Transmit(&huart2, (uint8_t *)&ch, 1, HAL_MAX_DELAY);
	return ch;
}

int __io_getchar(void)
{
	char ch;
	HAL_UART_Receive(&huart2, (uint8_t *)&ch, 1, 1);
	return ch;
}

/* USER CODE END 0 */

/**
  * @brief  The application entry point.
  * @retval int
  */
int main(void)
{
  /* MCU Configuration--------------------------------------------------------*/

  /* Reset of all peripherals, Initializes the Flash interface and the Systick. */
  HAL_Init();

  /* Configure the system clock */
  SystemClock_Config();

  /* Initialize all configured peripherals */
  MX_GPIO_Init();
  MX_FDCAN2_Init();
  MX_I2C2_Init();
  MX_SPI1_Init();
  MX_USART2_UART_Init();
  MX_USB_Device_Init();
  /* USER CODE BEGIN 2 */
  DWT_Init();

  printf("=== HAL init done, proceeding ... ===\n");
  HAL_GPIO_WritePin(CS_ADNS_GPIO_Port, CS_ADNS_Pin, GPIO_PIN_SET);
  HAL_GPIO_WritePin(CS_IMU_GPIO_Port, CS_IMU_Pin, GPIO_PIN_SET);
  setup();
  printf("=== User init done, proceeding ... ===\n");
  /* USER CODE END 2 */

  /* Infinite loop */
  /* USER CODE BEGIN WHILE */
  while (1)
  {
	  loop();
    /* USER CODE END WHILE */

    /* USER CODE BEGIN 3 */
  }
  /* USER CODE END 3 */
}

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
