evolutek/movement-tracker/firmware/Movement_Tracker.ioc

Mcu.UserName=STM32G491KEUx
PA0.GPIO_Label=RST_IMU
PA0.Signal=GPIO_Output
PA1.GPIO_Label=AU/INT
PA1.Signal=SharedStack_PA1
PA10.GPIO_Label=CS_ADNS
PA10.Signal=GPIO_Output
PA11.Signal=USB_DM
PA12.Signal=USB_DP
PA13.GPIO_Label=SWDIO
PA13.Signal=SYS_JTMS-SWDIO
PA14.GPIO_Label=SWCLK
PA14.Signal=SYS_JTCK-SWCLK
PA15.GPIO_Label=INT_IMU
PA15.Signal=GPXTI15
PA2.Signal=USART2_TX
PA3.Signal=USART2_RX
PA4.GPIO_Label=CS_IMU
PA4.Signal=GPIO_Output
PA5.Signal=SPI1_SCK
PA6.Signal=SPI1_MISO
PA7.Signal=SPI1_MOSI
PA8.Signal=I2C2_SDA
PA9.Signal=I2C2_SCL
PB0.GPIO_Label=INT_ANDS
PB0.Signal=GPXTI0
PB3.GPIO_Label=SWO
PB3.Signal=SYS_JTDO-SWO
PB4.GPIO_Label=STATUS
PB4.Signal=GPIO_Output
PB5.GPIO_Label=CAN_RX
PB5.Signal=FDCAN2_RX
PB6.GPIO_Label=CAN_TX
PB6.Signal=FDCAN2_TX
