evolutek/movement-tracker/firmware/Core/Inc/movement_tracker.h

/*
 * movement_tracker.h
 *
 *  Created on: Apr 4, 2024
 *      Author: danyj
 */

#ifndef INC_MOVEMENT_TRACKER_H_
#define INC_MOVEMENT_TRACKER_H_

void computePosition(int poll_rate);

float getHeading(void);
float getX(void);
float getY(void);

void setX(float value);
void setY(float value);
void setT(float value);
void setRelativeAngle(float delta);

#endif /* INC_MOVEMENT_TRACKER_H_ */
