evolutek/movement-tracker/firmware/Core/Inc/main.h

#define RST_IMU_Pin GPIO_PIN_0
#define RST_IMU_GPIO_Port GPIOA
#define AU_INT_Pin GPIO_PIN_1
#define AU_INT_GPIO_Port GPIOA
#define CS_IMU_Pin GPIO_PIN_4
#define CS_IMU_GPIO_Port GPIOA
#define INT_ANDS_Pin GPIO_PIN_0
#define INT_ANDS_GPIO_Port GPIOB
#define CS_ADNS_Pin GPIO_PIN_10
#define CS_ADNS_GPIO_Port GPIOA
#define SWDIO_Pin GPIO_PIN_13
#define SWDIO_GPIO_Port GPIOA
#define SWCLK_Pin GPIO_PIN_14
#define SWCLK_GPIO_Port GPIOA
#define INT_IMU_Pin GPIO_PIN_15
#define INT_IMU_GPIO_Port GPIOA
#define INT_IMU_EXTI_IRQn EXTI15_10_IRQn
#define SWO_Pin GPIO_PIN_3
#define SWO_GPIO_Port GPIOB
#define STATUS_Pin GPIO_PIN_4
#define STATUS_GPIO_Port GPIOB
#define CAN_RX_Pin GPIO_PIN_5
#define CAN_RX_GPIO_Port GPIOB
#define CAN_TX_Pin GPIO_PIN_6
#define CAN_TX_GPIO_Port GPIOB
