evolutek/movement-tracker/firmware/Core/Inc/runtime.h

#ifndef INC_RUNTIME_H_
#define INC_RUNTIME_H_

#include "main.h"

#define MVT_RESET

void setup(void);
void loop(void);

void HAL_I2C_ListenCpltCallback(I2C_HandleTypeDef *hi2c);
void HAL_I2C_AddrCallback(I2C_HandleTypeDef *hi2c, uint8_t TransferDirection, uint16_t AddrMatchCode);
void HAL_I2C_SlaveTxCpltCallback(I2C_HandleTypeDef *hi2c);
void HAL_I2C_SlaveRxCpltCallback(I2C_HandleTypeDef *hi2c);
void HAL_I2C_ErrorCallback(I2C_HandleTypeDef *hi2c);

#endif /* INC_RUNTIME_H_ */
