evolutek/movement-tracker/(commit log)

2023-09-20 Silkscreen edit
    [module-optique.kicad_pcb]
2023-09-20 minor fix
    [module-optique.kicad_pcb]
2023-09-20 Module Optique V1.0
    [module-optique.kicad_pcb, module-optique.kicad_sch, module-optique.step]
2023-09-21 Added 3D for the ADNS sensor
    [ADNS 9800 + Lentille .stp, module-optique.kicad_pcb]
2023-09-21 Added 3D for the ADNS 9800
    [module-optique.kicad_sch]
2023-09-22 made a bigger version
    to accommodate for lens mounting
    [module-optique-grand.kicad_pcb, module-optique-grand.step]
2023-09-23 modifications for the bigger version, and 3D
    [module-optique-grand.kicad_pcb, module-optique-grand.kicad_sch, module-optique-grand.step, module-optique.step]
2023-09-24 Generate output files
    [module-optique-grand.kicad_pcb]
2023-10-07 Put Module optique boards into V1 folder
    [module-optique-grand.kicad_pcb, module-optique-grand.kicad_sch, module-optique-grand.step, module-optique.kicad_pcb, module-optique.kicad_sch, module-optique.step]
2023-10-08 Wip of the movement tracker V2
    [movement-tracker.kicad_pcb, movement-tracker.kicad_sch]
2023-10-09 Movement Tracker V2
    [movement-tracker.kicad_pcb, movement-tracker.kicad_sch]
2023-12-28 Movement Tracker V3.0
    [movement-tracker.kicad_pcb, movement-tracker.kicad_sch]
2024-01-06 Add a pulldown resistor on RST
    [movement-tracker.kicad_pcb, movement-tracker.kicad_sch]
2024-03-04 ported all the strictly necessary functions
    seem to have ported all the strictly necessary functions for the most basic operation of the sensor to get yaw from the BNO085 - needs testing
2024-03-04 doesn't parse properly
    doesn't want to go into the parse input reports function for some reason
    [BNO085.c, BNO085.h, main.c]
2024-03-04 actually just resets all the time
    resets all the time, which probably causes the reports to roll back to none
    [BNO085.c, BNO085.h, firmware.ioc, main.c]
2024-03-07 can get a report once
    get one report, then the sensor just resets for no apparent reason
    as such, set_reports appears to be working and isn't the problem
    need more hardware investigation and more checks regarding the behaviour of the bno pins
    so actually, last comits hypothesis were wrong, it seems to parse properly, but i need to further check if the reports are disabled at reset, even tho it's not really a fix and more of a check to better understand this thing (EDIT : Sensor reports are indeed rolled back to none when the sensor is reset) (EDIT : reset reason is watchdog timeout (3))
    anyways, need to diagnose this fking repeated reset, which *seems* to happen according to a timestamp, as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
    [BNO085.c, BNO085.h, main.c]
2024-03-07 DON'T MERGE THIS ONE !
    bunch of tests, probably broke evertything
    init and ADNS still works tho
    [BNO085.c, BNO085.h, firmware.ioc, main.c, main.h]
2024-03-08 IT WORKS well, almost
    refacto-ed and it works now . . .
    Altho for some bizare reason, the init has to fail in order for the reports to be valid. . .
    and resetting the board breaks it
    still need some investigation
    EDIT : in fact, it works properly only when flashing the firmware, power cycling or resetting breaks it
    EDIT : increaing the delay after reset fixed it, except for the init fail
    [BNO085.c, main.c]
2024-03-08 init still fails, but it works otherwise
    there's definetly something wrong with the init sequence, but the sensor reports yaw fine
    [BNO085.c, BNO085.h]
2024-03-08 reading both sensors at once is not a problem
    in great need of some optimisation, but it's working fine
    [main.c]
2024-03-13 started trying to figure out the I2C comm
2024-03-22 not bad, high speed is an issue tho
    [ADNS9800.c, ADNS9800.h, ADNS9800_registers.h, BNO085.c, BNO085.h, BNO085_registers.h, Movement_Tracker.ioc, main.c]
2024-04-04 Started trying to work out I2C
2024-04-24 way more on yaw axis
2024-11-16 initial push of V4
    [movement-tracker-v3.step, movement-tracker.kicad_pcb, movement-tracker.kicad_sch]
2024-11-16 awaiting review
    [movement-tracker.kicad_pcb]
2024-11-16 waiting for review
    [movement-tracker.kicad_sch]
2025-01-02 added logo and label
    [movement-tracker.kicad_pcb]
2025-01-02 Release MVT V4.0
    [movement-tracker-v4.step, movement-tracker.kicad_pcb, movement-tracker.kicad_sch]
2026-01-28 Remove trash files
    [movement-tracker-v3.step]
2026-01-28 Schematics for V4.1
    [movement-tracker.kicad_sch]
2026-02-02 schematic and routing
    [movement-tracker.kicad_pcb, movement-tracker.kicad_sch]
2026-02-03 reprise du routage complete
    WIP, reste serigraphie, DRC, via stiching
    [movement-tracker.kicad_pcb, movement-tracker.kicad_sch]
2026-02-05 fin du routage
    [movement-tracker-v4.step, movement-tracker.kicad_pcb, movement-tracker.kicad_sch]
2026-02-05 fixed via stiching and added ground ring on L3
    [movement-tracker-v4.step, movement-tracker.kicad_pcb]
2026-02-24 Ajout de l'alimentation par le STlink
    [movement-tracker.kicad_pcb, movement-tracker.kicad_sch]
2026-03-06 V4.1 ready to prod
    [movement-tracker V4.1.step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]
2026-03-30 Fix output
    [movement-tracker V4.1.step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]
